timwhat/white-noise/CAD/README.md

# Onshape Source
[this link](https://cad.onshape.com/documents/e3248e877542224530ec66b3/w/ab92461b2a6e790aee280646/e/01c1a3ee09cbe98f66df6cb1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) is the onshape source document!

Additionally the other file is the step file is the configs of the robot!

Print settings in the [BOM.csv](BOM.csv)

# Wheel Print Settings WIP

- You make the bounding box a modifer and set it to zero walls, top and bottom layers

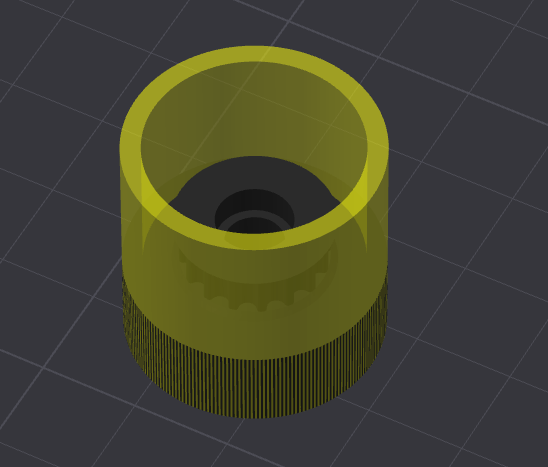
[picture p4: IMGS/aug6wheelslicersettings1.png]
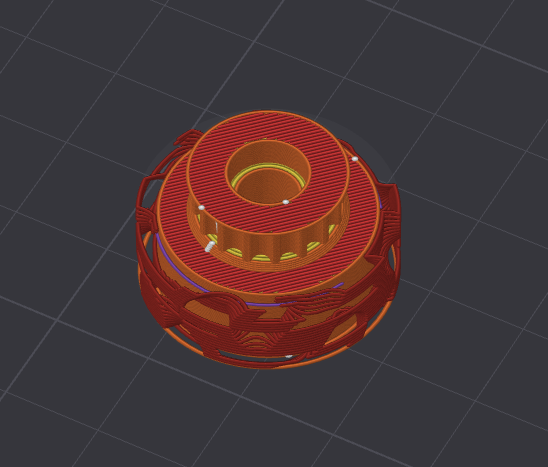
[picture p5: IMGS/aug6wheelslicersettings2.png]
|  |  |
|---|---|
