timwhat/white-noise/IMGS/aug5forkandwedgeconfigshot.png

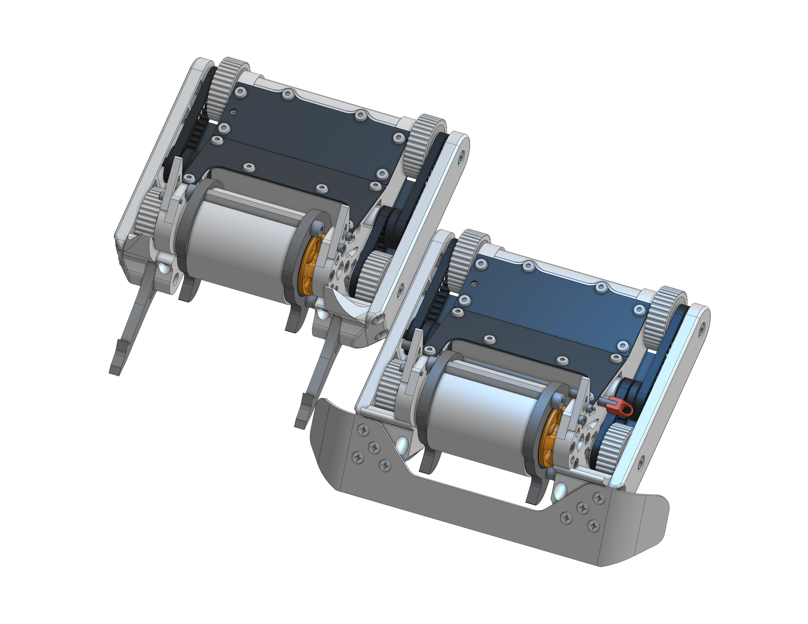
IMGS/aug5forkandwedgeconfigshot.png
