timwhat/white-noise/CAD/Individual Robot 3D print parts/Main Part Studio - Fork Mount.step

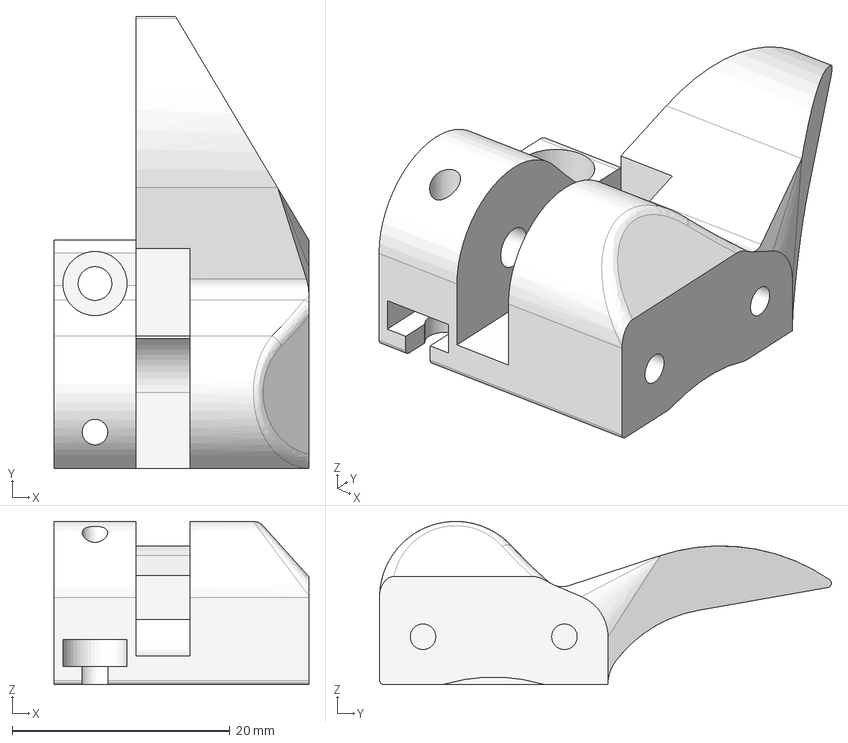
[picture p7: CAD file, 2026-08-07]
CAD/Individual Robot 3D print parts/Main Part Studio - Fork Mount.step
23.4 x 41.5 x 15.0 mm
