timwhat/white-noise/CAD/Individual Robot 3D print parts/Main Part Studio - Front Cover.step

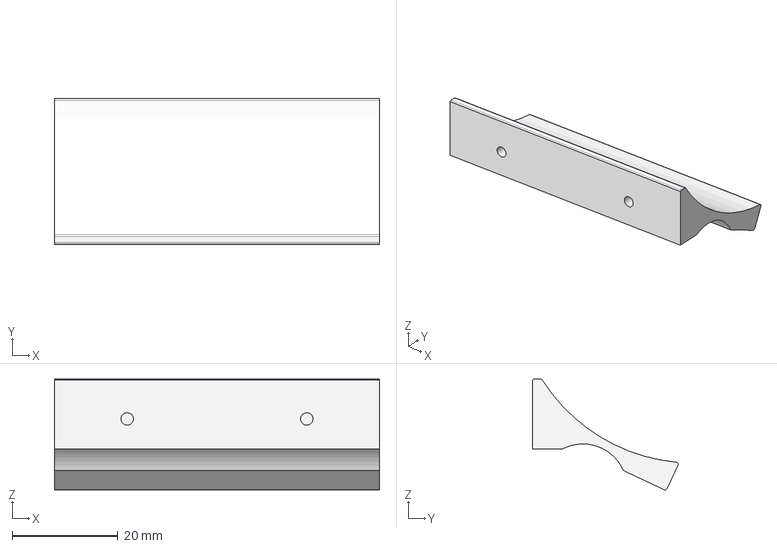
[picture p8: CAD file, 2026-08-07]
CAD/Individual Robot 3D print parts/Main Part Studio - Front Cover.step
61.5 x 27.6 x 21.0 mm
