timwhat/white-noise/CAD/Individual Robot 3D print parts/Main Part Studio - Weapon Hub.step

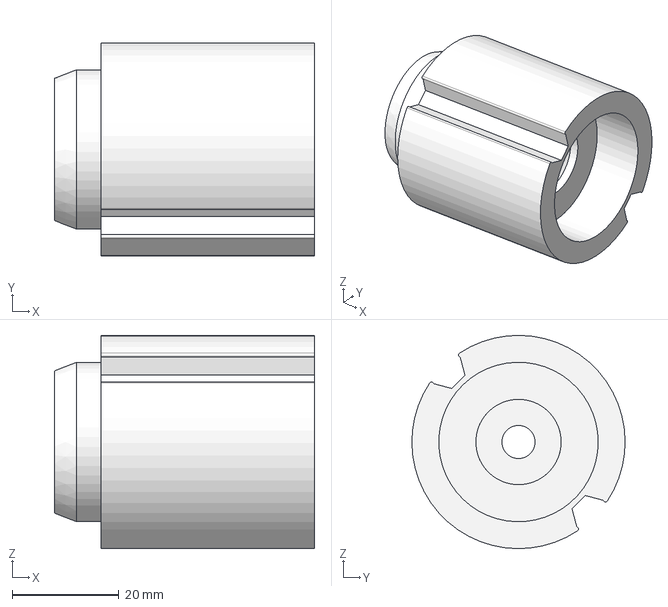
[picture p9: CAD file, 2026-08-07]
CAD/Individual Robot 3D print parts/Main Part Studio - Weapon Hub.step
48.8 x 40.0 x 40.0 mm
