timwhat/white-noise/CAD/Individual Robot 3D print parts/Main Part Studio - Inside Rail.step

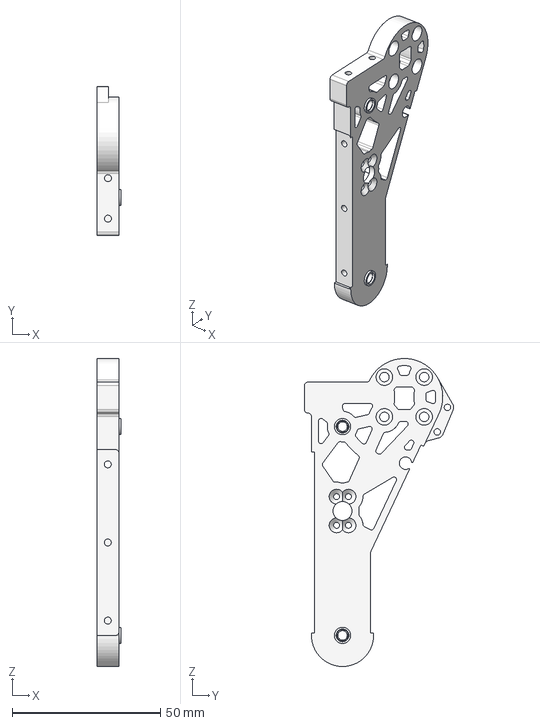
[picture p10: CAD file, 2026-08-07]
CAD/Individual Robot 3D print parts/Main Part Studio - Inside Rail.step
8.20 x 50.4 x 104.0 mm
