timwhat/white-noise/CAD/Individual Robot 3D print parts/Main Part Studio - Back Bumper.step

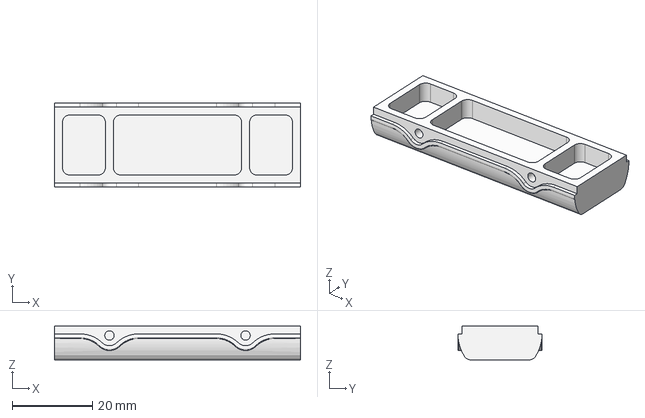
[picture p11: CAD file, 2026-08-07]
CAD/Individual Robot 3D print parts/Main Part Studio - Back Bumper.step
61.4 x 21.0 x 8.45 mm
