timwhat/white-noise/CAD/Individual Robot 3D print parts/Main Part Studio - Outside Rail (R).step

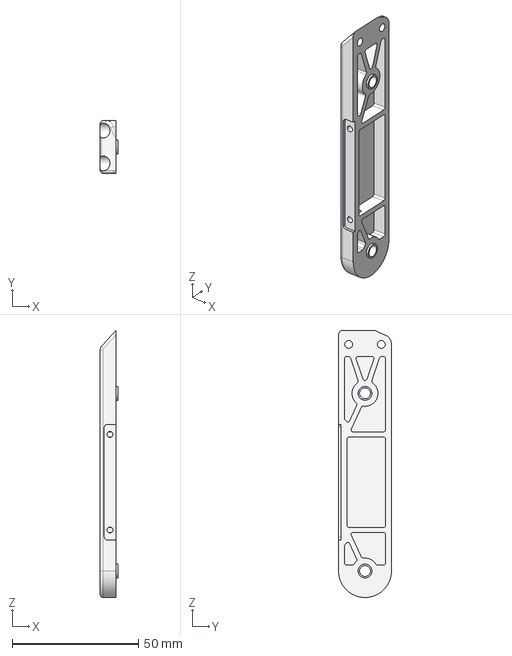
[picture p12: CAD file, 2026-08-07]
CAD/Individual Robot 3D print parts/Main Part Studio - Outside Rail (R).step
7.00 x 21.0 x 105.9 mm
