timwhat/white-noise/CAD/Individual Robot 3D print parts/Main Part Studio - Ear of Adjustability.step

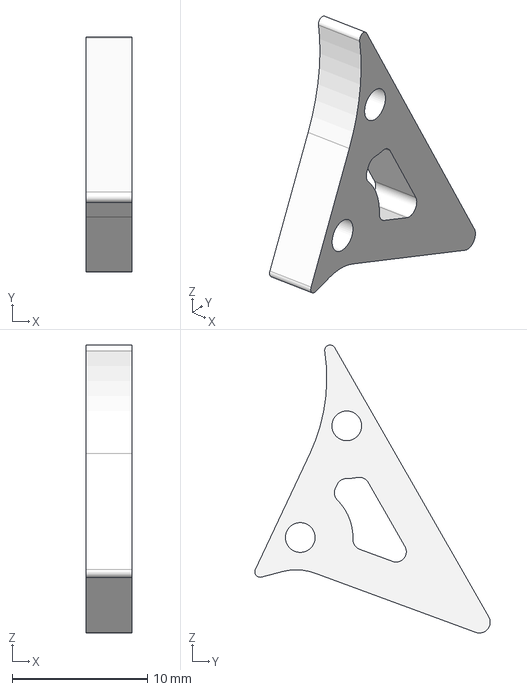
[picture p13: CAD file, 2026-08-07]
CAD/Individual Robot 3D print parts/Main Part Studio - Ear of Adjustability.step
3.40 x 17.4 x 21.3 mm
