timwhat/white-noise/CAD/Individual Robot 3D print parts/Main Part Studio - TPU Motor Sock.step

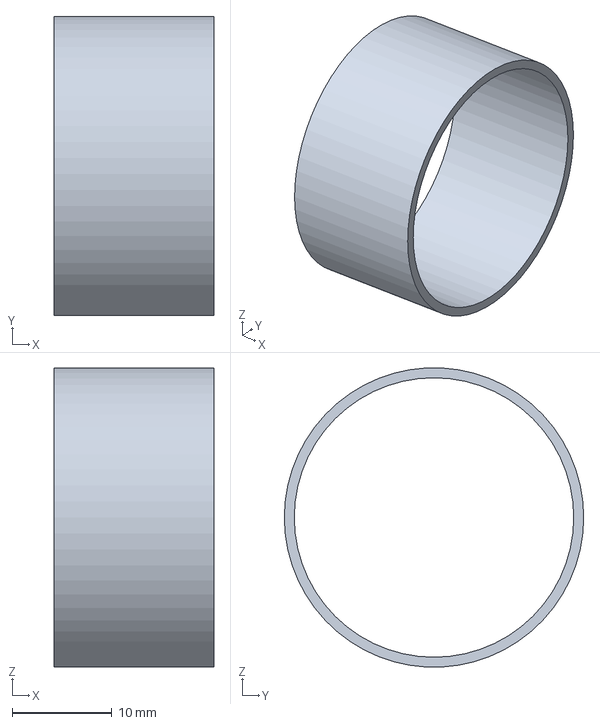
[picture p14: CAD file, 2026-08-07]
CAD/Individual Robot 3D print parts/Main Part Studio - TPU Motor Sock.step
16.0 x 30.0 x 30.0 mm
