timwhat/white-noise/CAD/Individual Robot 3D print parts/Main Part Studio - Inside Rail (R).step

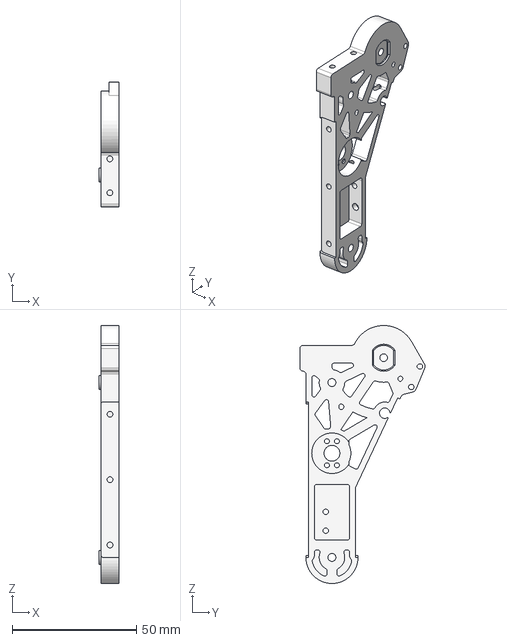
[picture p15: CAD file, 2026-08-07]
CAD/Individual Robot 3D print parts/Main Part Studio - Inside Rail (R).step
8.20 x 50.4 x 104.0 mm
