timwhat/white-noise/CAD/Individual Robot 3D print parts/Molds/Fork Pillows - Pillow Mold.step

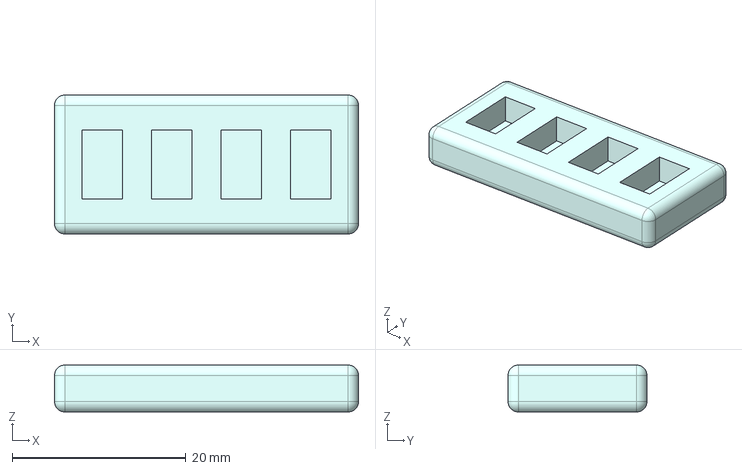
[picture p16: CAD file, 2026-08-07]
CAD/Individual Robot 3D print parts/Molds/Fork Pillows - Pillow Mold.step
35.0 x 16.0 x 5.40 mm
