timwhat/white-noise/CAD/Individual Robot 3D print parts/Wheel - Gyroid Bounding Box.step

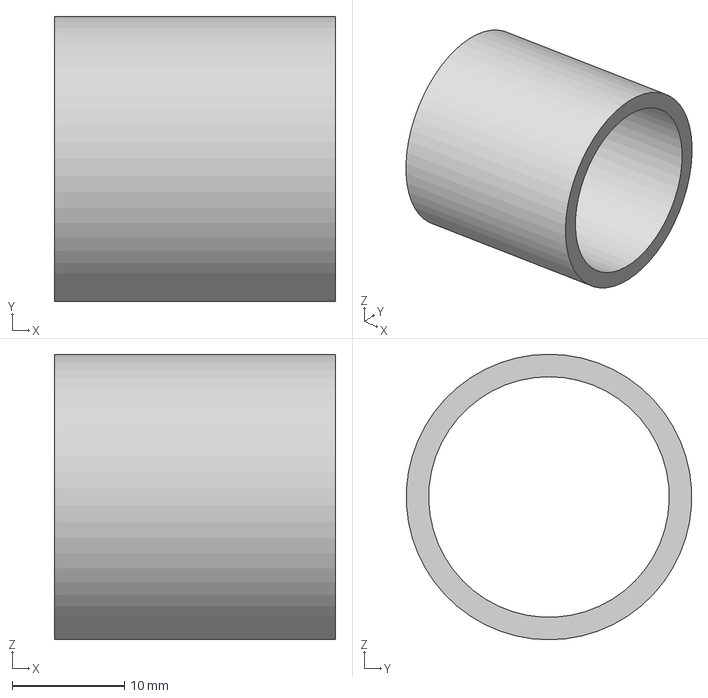
[picture p17: CAD file, 2026-08-07]
CAD/Individual Robot 3D print parts/Wheel - Gyroid Bounding Box.step
25.0 x 25.4 x 25.4 mm
