timwhat/white-noise/CAD/whiteNoiseBothConfigsV5.step

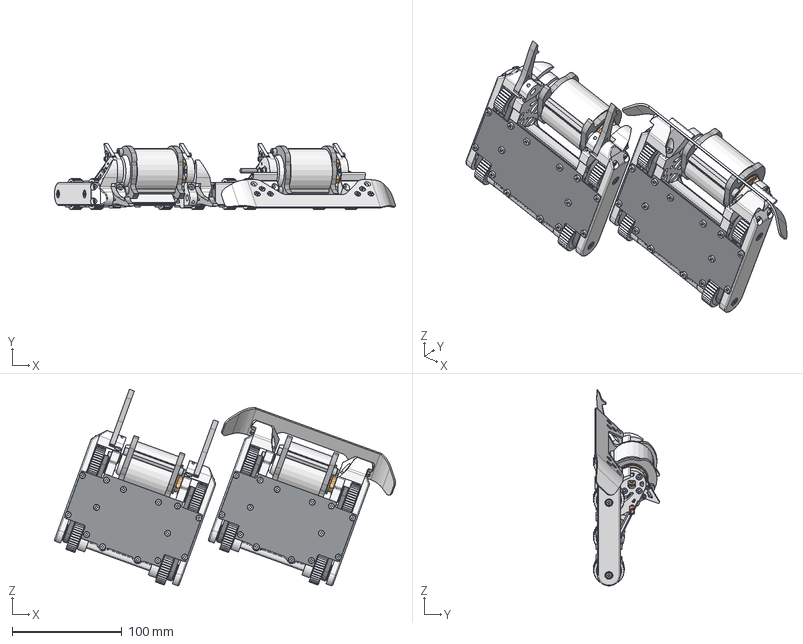
[picture p18: CAD file, 2026-08-07]
CAD/whiteNoiseBothConfigsV5.step
310.5 x 60.1 x 179.0 mm
4x7x2.5 Bearing (1) x 2
Rim x 2
Tire x 2
4x7x2.5 Bearing x 2
16t GT2 3mm Pulley (0.748" Wide, *0.228" Circular Bore) x 6
96817A330_Thread-Forming Screws for Thin Plastic x 70
Fork
Fork (R)
Fork Pillow x 2
Fork Mount
Hex socket head cap screw M3x0.50 x 12 x 2
Fork Mount (R)
5x8x2.5 Bearing x 4
Hex socket head cap screw M4x0.70 x 12 x 8
Repeat Direct Drive 2822 V3 x 4
Weapon Hub x 2
Drisk Disk x 2
M3 45mm Standoff x 4
TPU Motor Sock x 2
Back Bumper x 2
Ear of Adjustability x 2
Repeat Mini Brushed Mk2 - 4mm x 16
Radio Reciever x 2
Drive ESC x 2
Hex socket head cap screw M2x0.40 x 8 x 8
ANT-AXLE-SHORT x 2
Hex socket countersunk head screw M2x0.4 x 4 x 8
16t GT2 3mm Pulley (1" Wide, *0.157" Circular Bore) x 4
Front Cover x 2
Hex socket head cap screw M3x0.50 x 8 x 8
35T 3M 4mm Wide Belt x 6
Outside Rail (R) x 2
90323A218_18-8 Stainless Steel Low-Profile Precision Shoulder Screw x 8
Inside Rail x 2
94459A769_Heat-Set Inserts for Plastic x 8
Battery x 2
Hex socket head cap screw M3x0.50 x 16 x 2
44T 3M 4mm Wide Belt x 4
Bottom CF Plate x 2
SHCS 4-40x375_HX-SHCS 0.112-40x0.375x0.375-S__ DE 12045 x 2
switch half R1.1__ DE 35 x 4
copper tab_through hole__ DE 10519 x 2
copper tab__ DE 11277 x 2
Outside Rail x 2
Angled Plate x 2
M3x9x.08 Washer x 2
Ear of Adjustability (R) x 2
Weapon ESC x 2
Inside Rail (R) x 2
Top CF Plate x 2
90065A107 x 6
Wedge Holder
AntWej
Wedge Holder (R)
