timwhat/white-noise/CAD/Individual Robot 3D print parts/Molds/Wheel - Bottom Half Mold.step

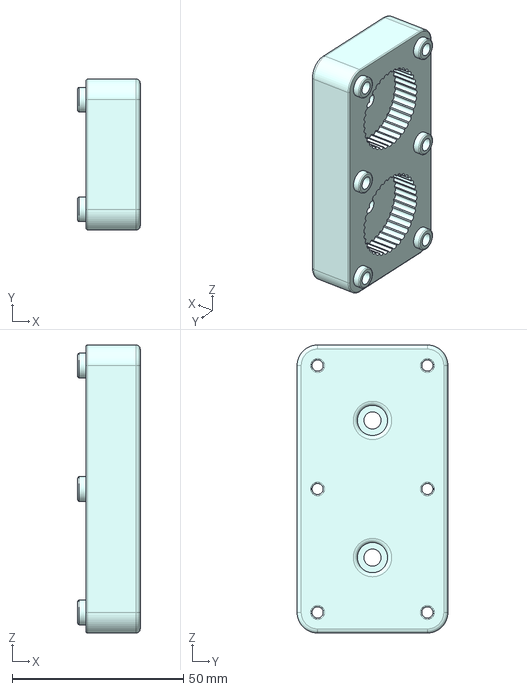
[picture p19: CAD file, 2026-08-07]
CAD/Individual Robot 3D print parts/Molds/Wheel - Bottom Half Mold.step
18.2 x 44.0 x 84.0 mm
