timwhat/white-noise/CAD/Individual Robot 3D print parts/Molds/Wheel - Top Half Mold.step

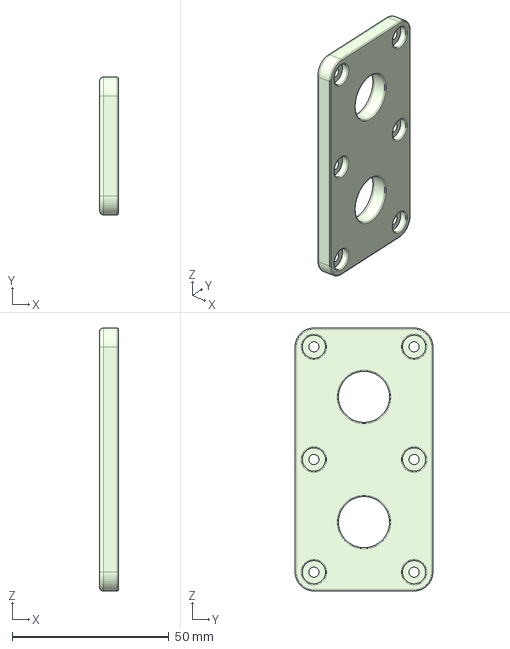
[picture p20: CAD file, 2026-08-07]
CAD/Individual Robot 3D print parts/Molds/Wheel - Top Half Mold.step
6.00 x 44.0 x 84.0 mm
