timwhat/white-noise/CAD/Individual Robot 3D print parts/Wedge Config Part Studio - Wedge Holder (R).step

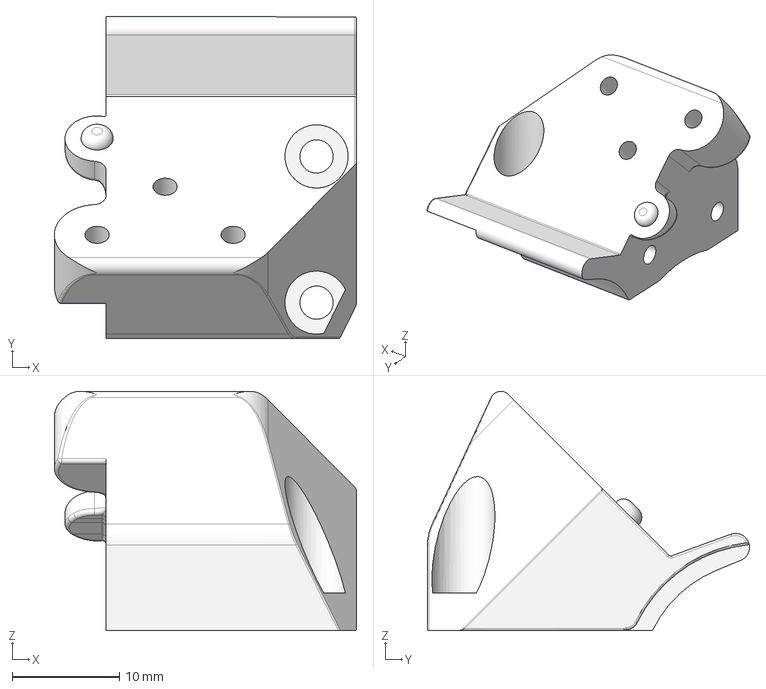
[picture p21: CAD file, 2026-08-07]
CAD/Individual Robot 3D print parts/Wedge Config Part Studio - Wedge Holder (R).step
28.2 x 30.1 x 22.3 mm
