timwhat/white-noise/CAD/Individual Robot 3D print parts/Wheel - Rim.step

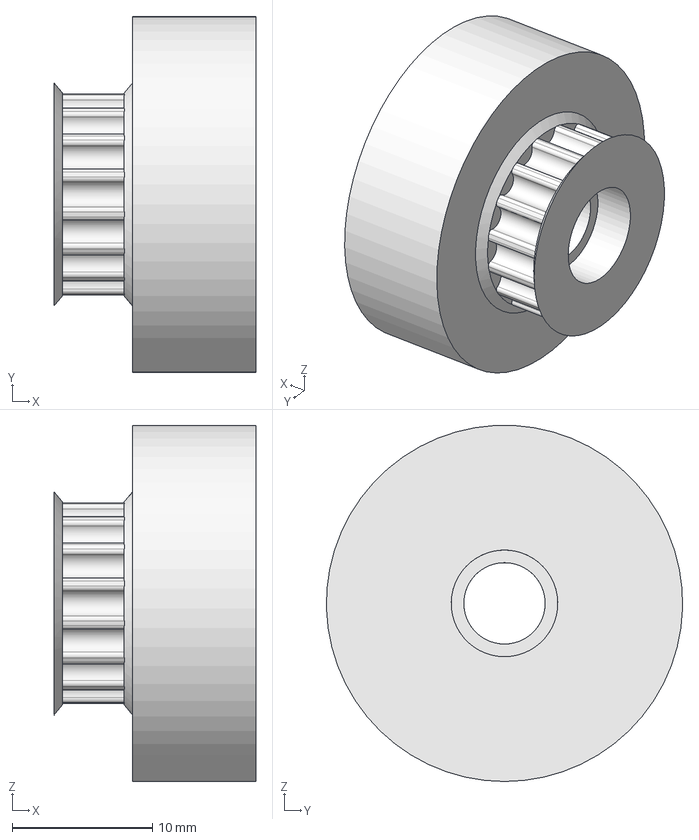
[picture p22: CAD file, 2026-08-07]
CAD/Individual Robot 3D print parts/Wheel - Rim.step
14.4 x 25.4 x 25.4 mm
