timwhat/white-noise/(list of files, cad)

Other CAD files:
CAD/Individual Robot 3D print parts/Main Part Studio - Fork Mount (R).step
CAD/Individual Robot 3D print parts/Main Part Studio - Outside Rail.step
CAD/Individual Robot 3D print parts/Wedge Config Part Studio - Wedge Holder.step
