timwhat/white-noise/(commit log)

2026-08-05 addition of CSVs, Steps, etc
    [BOM.csv, part-sourcing.csv, the-math.csv, whiteNoiseBothConfigsV4.step]
2026-08-05 adding more to readme!
    [part-sourcing.csv]
2026-08-06 updates to photos and BOM
    [BOM.csv, part-sourcing.csv]
2026-08-07 additions to 3dp parts + wiring diagram
    [Fork Pillows - Pillow Mold.step, Main Part Studio - Back Bumper.step, Main Part Studio - Ear of Adjustability.step, Main Part Studio - Fork Mount (R).step, Main Part Studio - Fork Mount.step, Main Part Studio - Front Cover.step, Main Part Studio - Inside Rail (R).step, Main Part Studio - Inside Rail.step]
2026-08-07 adding link to print/mold instructions
